CorazonHK/voice-recognition-project/F103-Version/Photos/完好的板子.jpg

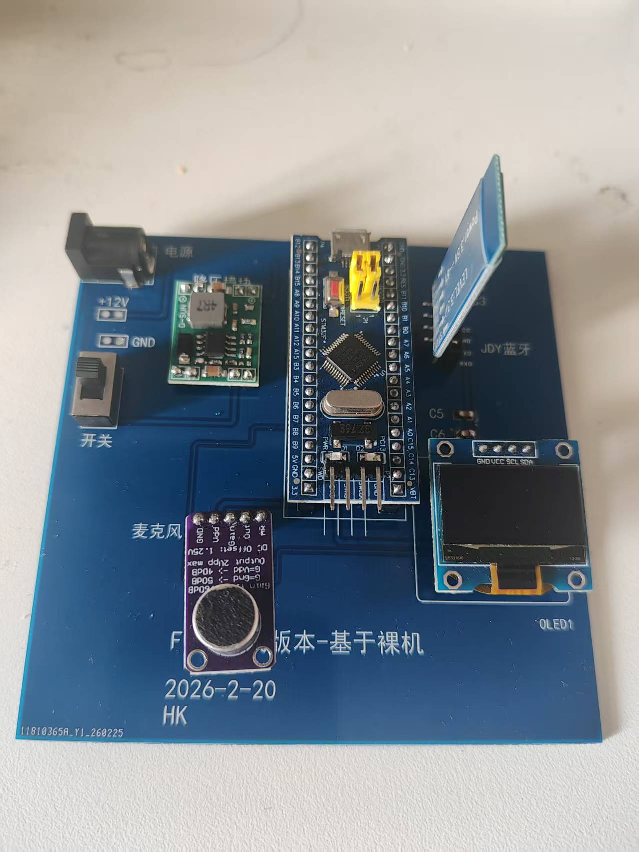
F103-Version/Photos/完好的板子.jpg
