CorazonHK/voice-recognition-project/F103-Version/Photos/烧坏的板子，短路过热.jpg

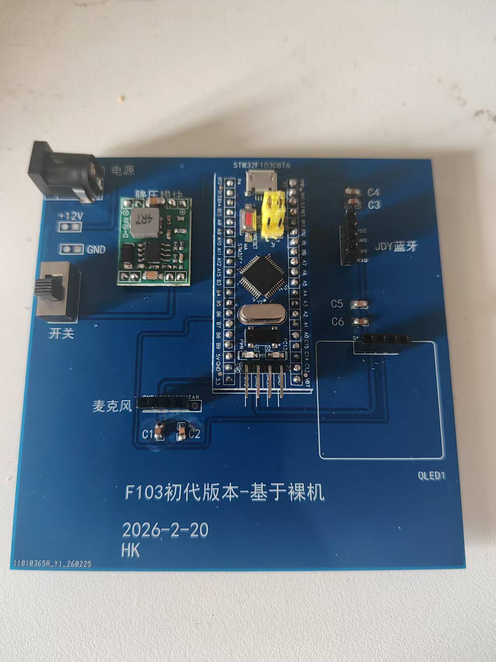
F103-Version/Photos/烧坏的板子，短路过热.jpg
