CorazonHK/voice-recognition-project/README.md

## STM32 语音控制系统

<div align="center">






**从 PCB 到 AI 的全栈语音识别项目 | 端侧采集 + PC 端识别**

[📚 文档](#-文档导航) | [🛠️ 硬件](#️-硬件设计) | [💻 固件](#-固件) | [🐍 Python](#-python-端) | [📊 成果](#-成果)

</div>

---

## 📌 项目简介

这是一个**从零开始**的语音控制系统，覆盖了：

- **硬件**：原理图设计、PCB  Layout、焊接调试
- **固件**：STM32 裸机开发、ADC+DMA 采集、串口通信
- **算法**：MFCC 特征提取、CNN 模型训练、实时推理
- **PC 端**：Python 服务器、数据采集、模型部署

**核心链路**：
```
声音 → MAX9814 麦克风 → STM32F103 采集 → HC-06 蓝牙 → PC 端 MFCC+CNN → 识别结果
```

---

## ✨ 功能特性

| 模块 | 功能 | 状态 |
| --- | --- | --- |
| 🎙️ 音频采集  | 8000Hz 采样，DMA 循环转运 | ✅ 完成 |
| 📡 蓝牙传输  | HC-06，9600bps，数据包协议 | ✅ 完成 |
| 🖥️ OLED 显示 | 实时显示识别结果、系统状态 | ✅ 完成 |
| 📝 数据采集  | PC 端脚本录制 文件 | ✅ 完成 |
| 🧠 模型训练  | MFCC + CNN，93% 准确率 | ✅ 完成 |
| ⚡ 实时识别  | Python 服务器实时推理 | ✅ 完成 |
| 🔋 电源系统  | 5V 输入，3.3V 稳压，去耦电容 | ✅ 完成 |
| 📦 版本迭代  | F103 原型 → F407 计划中 | 🚧 进行中 |

---

## 🛠️ 硬件设计

### 核心硬件

| 模块 | 型号 | 说明 |
| --- | --- | --- |
| 主控 | STM32F103C8T6 核心板 | 原型验证用 |
| 麦克风 | MAX9814 模块 | 自带 AGC，模拟输出  |
| 蓝牙 | HC-06 | 9600bps，最稳定 |
| 屏幕 | 0.96寸 OLED | I2C 接口，0x78 地址 |
| 电源 | 5V 降压模块 | 电池供电方案 |

### 引脚分配

| 模块 | 信号 | STM32 引脚 | 备注 |
| --- | ---- | --- | --- |
| 麦克风 | OUT  | PA0 | ADC 输入 |
| | VDD  | 3.3V | 加去耦电容 |
| | GND  | GND | 模拟地单独走 |
| 蓝牙 | TXD  | PB11 (USART3_RX) | 模块发送→STM32 接收 |
| | RXD  | PB10 (USART3_TX) | STM32 发送→模块接收 |
| | VCC  | 3.3V | 加去耦电容 |
| OLED | SCL  | PB6 | I2C 时钟 |
| | SDA  | PB7 | I2C 数据 |
| | VCC  | 3.3V | 加去耦电容 |

### PCB 设计要点

- **电源线加粗**：5V/3.3V 走 27mil
- **去耦电容**：每个模块 VCC 旁放 10μF+0.1μF，紧贴引脚
- **模拟地处理**：MAX9814 GND 单独走，单点接数字地

### 硬件版本迭代

| 版本 | 说明 | 状态 |
| ---- | --- | --- |
| v1.0 | 第一版 PCB（引脚排序错误） | ❌ 废板 |
| v1.1 | 修正 MAX9814 引脚排序 | ✅ 可用 |
| v1.2 | 优化去耦电容位置 | ✅ 稳定 |
| v2.0 | F407 版本（计划中） | 🚧 开发中 |

---

## 💻 固件

### 开发环境

- **IDE**：Keil MDK
- **库**：STM32 标准库
- **调试**：ST-Link

### 软件架构（裸机）

| 模块 | 实现 | 说明 |
| --- | --- | --- |
| ADC 采集  | DMA 循环模式，512 缓冲区 | 自动转运，不占 CPU |
| 蓝牙发送  | USART3，9600bps | 每 20ms 发一包 |
| OLED 显示 | I2C 驱动 | 实时显示状态 |
| 数据协议  | `AA 55` + 320 字节数据 + `0D 0A` | 帧头同步，防止粘包 |

## 🐍 Python 端

### 环境配置

| 组件 | 版本 | 说明 |
| --- | --- | --- |
| Python | 3.11 | TensorFlow 兼容版本 |
| TensorFlow | 2.15.0 | 训练和推理 |
| librosa | 0.10.1 | MFCC 特征提取 |
| pyserial | 最新 | 串口通信 |

```bash
# 创建虚拟环境
python -m venv .venv
.venv\Scripts\activate

# 安装依赖
pip install -r requirements.txt
```

### 脚本说明

| 脚本 | 功能 | 用法 |
| --- | --- | --- |
| `find_device.py` | 列出可用串口 | `python find_device.py` |
| `record_data_from_stm32.py` | 采集数据存 WAV | `python record_data_from_stm32.py` |
| `train_model.py` | 训练 CNN 模型  | `python train_model_from_stm32.py` |
| `getMFCC.py` | 实时识别 | `python getMFCC.py` |
| `test_env.py` | 验证环境 | `python test_env.py` |

### MFCC 特征提取

MFCC 是语音识别的黄金标准，主要优势：

- **模拟人耳**：梅尔刻度让机器“听得像人一样”
- **大幅降维**：16000 点 → 1300 维，压缩 12 倍
- **抗噪性强**：整个流程天然滤掉噪声

### 模型训练

- **模型**：3 层 Conv1D + 全连接
- **数据**：Google Speech Commands + 自采数据
- **准确率**：93%（测试集）
- **输出**：`speech_cnn.h5`

---

## 📊 成果

### 性能指标

| 指标 | 数值 |
| --- | --- |
| 采样率 | 8000Hz |
| 波特率 | 9600bps |
| 数据包 | 320 字节/包，20ms |
| 模型准确率 | 93% |
| 连续运行 | >24 小时 |
| 蓝牙距离 | >10 米 |

## 🚀 快速开始

### 硬件准备

1. 按 [引脚分配表] 连接模块
2. 接入 5V 电源
3. 用 ST-Link 下载固件

### 固件烧录

```bash
# 打开 Keil 工程
Firmware/F103/MDK-ARM/Project.uvprojx

# 编译下载
```

### Python 环境

```bash
# 创建虚拟环境
python -m venv .venv
.venv\Scripts\activate

# 安装依赖
pip install -r Python/requirements.txt

# 运行实时识别
python Python getMFCC.py
```

---

## 🧠 经验总结

### 硬件

1. **以实物为准**：MAX9814 引脚排序
2. **电源线要粗**：20-30mil 起步
3. **电容要贴芯片放**：0.1μF 必须紧贴引脚

### 软件

1. **裸机够用就别急着上系统**
2. **帧头同步很重要**：`AA 55` 解决粘包问题
3. **数据分包比降低速率更有效**

### 算法

1. **MFCC 参数不能错**：训练和推理必须一致
2. **CMSIS-DSP 有坑**：arm_bitreversal 自己手写 fix
3. **数据增强有用**：加了噪声后识别率提升明显

---

## 📄 许可证

MIT License

---

## 🙏 致谢

- 江协科技 - 标准库教程
- 正点原子 - FreeRTOS 教程
- Google - Speech Commands 数据集
- librosa 团队 - 优秀的音频处理库

---

<div align="center">

**如果这个项目对你有帮助，欢迎 Star ⭐**

</div>
