CorazonHK/voice-recognition-project/F103-Version/Docs/F103版本说明.md

## F103 版本说明

> 📅 **版本**：v1.0  
> 🔧 **主控**：STM32F103C8T6  
> 📌 **状态**：✅ 已完成（原型验证）  
> 🎯 **用途**：快速验证硬件方案 + 算法可行性

---

### 🎯 这个版本的目标

F103 版本从一开始就不是“最终产品”，它的定位很明确：

| 目标 | 说明 |
| --- | --- |
| ✅ 快速验证硬件 | MAX9814、HC-06、OLED 能不能正常工作 |
| ✅ 打通通信链路 | 音频数据能不能从 STM32 传到 PC |
| ✅ 验证算法 | MFCC + CNN 在 PC 端能不能跑通 |
| ✅ 采集真实数据 | 用这套硬件录一批自己的语音 |
| ❌ 不是最终架构 | 不上 FreeRTOS，不用复杂架构 |

**一句话**：先让东西跑起来，再考虑怎么跑得好。

---

### 📦 这个版本做了什么

#### 硬件方面

| 模块 | 型号 | 状态 |
| --- | --- | --- |
| 主控 | STM32F103C8T6 核心板  | ✅ 稳定 |
| 麦克风 | MAX9814 模块 | ✅ 稳定（引脚排序已核对） |
| 蓝牙 | HC-06 | ✅ 稳定（9600bps） |
| 屏幕 | 0.96寸 OLED | ✅ 稳定（I2C 0x78） |
| 电源 | 5V 降压模块 + AMS1117 | ✅ 稳定 |

**硬件迭代记录**：
- 第一版 PCB：发现 MAX9814 引脚排序和网上资料不一样 → 第二版修正
- 第二版 PCB：蓝牙从 JDY-31 换成 HC-06 → 稳定性大幅提升
- 第三版 PCB：去耦电容位置优化 → ADC 数据跳动从 ±20 降到 ±2

#### 软件方面（裸机）

| 模块 | 实现方式 | 状态 |
| --- | --- | --- |
| ADC 采集 | DMA 循环模式，512 缓冲区 | ✅ 稳定 |
| 蓝牙发送 | USART3，9600bps，帧头 `AA 55` + 数据 + `0D 0A` | ✅ 稳定 |
| OLED 显示  | I2C 驱动，显示实时状态 | ✅ 稳定 |
| 数据包协议 | 每包 320 字节（160 个采样点） | ✅ 稳定 |

#### PC 端

| 脚本 | 功能 | 状态 |
| --- | --- | --- |
| `record_word_from_stm32.py` | 采集数据，存 WAV | ✅ 可用 |
| `train_model_from_stm32.py` | 训练 CNN 模型 | ✅ 可用（93% 准确率） |
| `getMFCC.py` | 实时识别 | ✅ 可用 |
| `find_device.py` | 列出可用串口 | ✅ 可用 |
| `test_env.py` | 验证 Python 环境 | ✅ 可用 |

---

### 📊 这个版本的成果

| 指标 | 数值 | 说明 |
| --- | --- | --- |
| 采样率 | 8000Hz | 语音识别够用 |
| 波特率 | 9600bps | HC-06 最稳定 |
| 数据包大小 | 320 字节/包 | 160 个采样点 |
| 发送间隔 | 20ms | 和帧率匹配 |
| 模型准确率 | 93% | 在自己录的数据集上 |
| 连续运行时间 | >24 小时 | 不卡死、不掉线 |
| 蓝牙有效距离 | >10 米 | 室内够用 |

---

### 🧠 学到了什么

#### 硬件方面的经验

1. **以实物为准**  
   MAX9814 的引脚排序让我长记性了：永远不要相信网上的引脚图，拿到模块先拿万用表打一遍。

2. **电源线要粗**  
   第一版板子电源线太细，蓝牙一发射电压就掉。后来加粗到 27mil，问题解决。

3. **电容要贴芯片放**  
   去耦电容放远了等于白放。0.1μF 必须紧贴芯片引脚，这个坑我踩过。

#### 软件方面的经验

1. **裸机够用就别急着上系统**  
   F103 版本没用 FreeRTOS，少了很多调试的麻烦。先把功能跑通，上系统的事留给 F407。

2. **帧头同步很重要**  
   一开始没加帧头，PC 端经常收错数据。加上 `AA 55` 之后，再也没出过问题。

3. **数据分包比降低速率更有效**  
   从一次发 1024 字节改成每 20ms 发 320 字节，传输稳定性大幅提升。

#### 算法方面的经验

1. **MFCC 的参数不能错**  
   hop_length、n_mfcc、n_fft 这些参数，训练和推理必须完全一致，否则识别率直接归零。

2. **CMSIS-DSP 有坑**  
   arm_bitreversal_32 链接不上的问题，最后自己手写 fix 才解决。官方库不一定靠谱。

---

### ⚠️ 这个版本的局限

1. **裸机架构，代码耦合度高**  
   所有功能都挤在 main 循环里，加新功能越来越难。

2. **没有用 FreeRTOS**  
   任务管理靠轮询，实时性一般，CPU 利用率不高。

3. **F103 的 RAM 太小**  
   20KB 要放 ADC 缓冲区、全局变量、栈，有点捉襟见肘。

4. **采样率只有 8000Hz**  
   够用，但想提高识别率的话，还是 16000Hz 更好。

5. **蓝牙还是 9600bps**  
   稳是稳，但想传更高质量的数据，带宽不够。

---

### 🚀 F407 版本计划怎么改进

| 改进点 | F103 版本 | F407 版本计划 |
| --- | --- | --- |
| 操作系统 | 裸机 | **FreeRTOS**  |
| 任务数 | 1个 main 循环 | 4个独立任务 |
| 数据传递 | 全局变量 | **队列** |
| 采样率 | 8000Hz | **16000Hz** |
| 缓冲区 | 512 点 | **1024 点** |
| RAM | 20KB | 192KB（够用） |
| 代码可维护性 | 一般 | **好** |

---

### 📝 总结

F103 版本的任务完成了：
- ✅ 硬件方案验证通过
- ✅ 通信链路打通
- ✅ 算法跑通，准确率 93%
- ✅ 数据采集搞定

它的价值不是“能跑多快”，而是**让 F407 版本可以站在它的肩膀上**。

没有 F103 版本踩的那些坑，F407 版本不可能一次成功。

---
