CorazonHK/voice-recognition-project/F103-Version/Docs/硬件引脚分配表.md

## 硬件引脚分配表（STM32F103C8T6）

> 📅 **版本**：F103原型验证版  
> 🔧 **主控**：STM32F103C8T6核心板   
> ⚠️ **注意**：蓝牙用的是 **USART3**，且 **TXD/RXD 是交叉连接**

---

### 📍 引脚分配总表

| 模块 | 引脚 | STM32引脚 | 功能 | 备注 |
| --- | --- | --- | --- | --- |
| **电源** | 5V_IN | 核心板5V脚 | 系统总电源 | 从5V降压模块来 |
| | 3.3V | 核心板3.3V脚 | 给外设供电 | 核心板输出 |
| | GND | 核心板GND | 公共地 | 所有GND最后铺铜连接 |
| **麦克风** | OUT | **PA0** | 音频模拟输入 | ADC1_CH0 |
| (MAX9814) | VDD | 3.3V | 模块供电 | 加10μF+0.1μF去耦 |
| | GND | GND | 电源地 | 模拟地单独走线 |
| | GAIN | 悬空 | 增益选择 | 悬空=60dB |
| | AR | 悬空 | 攻击/释放比 | 悬空=1:4000 |
| **蓝牙** | **TXD** | **PB11 (USART3_RX)** | 模块发送→STM32接收 | ⭐ 注意：PB11 是 RX  |
| (HC-06) | **RXD** | **PB10 (USART3_TX)** | STM32发送→模块接收 | ⭐ 注意：PB10 是 TX  |
| | VCC | 3.3V | 模块供电 | 加10μF+0.1μF去耦 |
| | GND | GND | 电源地 | |
| **OLED** | SCL | **PB6** (I2C1_SCL) | I2C时钟线 | 模块自带4.7k上拉 |
| (0.96寸) | SDA | **PB7** (I2C1_SDA) | I2C数据线 | 模块自带4.7k上拉 |
| | VCC | 3.3V | 模块供电 | 加10μF+0.1μF去耦 |
| | GND | GND | 电源地 | |
| **调试接口** | SWDIO | **PA13** | 调试数据线 | 核心板引出 |
| | SWCLK | **PA14** | 调试时钟线 | 核心板引出 |
| | NRST | NRST | 复位 | 可选，接调试器 |

---

### 🔌 蓝牙接线特别说明

**这是最容易接错的地方，一定要看仔细：**

| HC-06 引脚 | 接 STM32 引脚 | 说明 |
| --- | --- | --- |
| TXD（模块发送） | **PB11 (USART3_RX)** | 模块发送 → STM32 接收 |
| RXD（模块接收） | **PB10 (USART3_TX)** | STM32 发送 → 模块接收 |

**口诀**：**TXD 接 RX，RXD 接 TX**（交叉连接）

---

### 📊 按外设分组

#### 电源网络
| 网络名 | 来源 | 去向 | 线宽建议 |
| --- | --- | --- | --- |
| 5V_IN  | 电源接口 | 核心板5V脚  | 20-30mil |
| 3.3V | 核心板3.3V脚 | 所有外设VCC | 20mil |
| GND | 电源接口 | 所有外设GND | 铺铜 |

#### 模拟信号（要特别小心）
| 信号 | 引脚 | 注意事项 |
| --- | ---- | --- |
| 麦克风输入 | PA0  | 走线尽量短，远离数字信号 |

#### 数字通信
| 接口 | 引脚 | 功能 | 速率 |
| --- | ---- | --- | --- |
| USART3_TX | PB10 | 蓝牙发送（STM32→模块） | 9600bps |
| USART3_RX | PB11 | 蓝牙接收（模块→STM32） | 9600bps |
| I2C1_SCL  | PB6  | OLED时钟 | 100kHz  |
| I2C1_SDA  | PB7  | OLED数据 | 100kHz  |

---

### 🎯 选型理由

#### PB10/PB11 做蓝牙
- 用 USART3 避开 USART1（PA9/PA10 留着备用）
- 核心板引出这些脚，不用飞线
- HC-06 默认 9600bps，正好匹配

#### 为什么 TXD 接 PB11？
- HC-06 的 TXD 是**发送**数据
- STM32 的 PB11 是 USART3 的 **RX（接收）**
- 一个发一个收，正好对上

---

### 📐 PCB 布局建议

1. **PA0 麦克风输入**
   - 尽量靠近麦克风模块
   - 周围不要走数字信号线
   - 最好用地线包起来

2. **PB10/PB11 蓝牙**
   - 放在板子边缘（天线朝外）
   - 天线下方不要铺铜、不要走线
   - 远离电机、电源等干扰源

3. **PB6/PB7 OLED**
   - 放在方便插屏幕的位置
   - I2C 走线可以长一点，没问题

4. **电源线**
   - 5V_IN 和 3.3V 走 20-30mil
   - 每个模块旁边放 10μF+0.1μF 去耦电容

---

### ⚠️ 实测确认过的事

| 项目 | 状态 | 说明 |
| --- | --- | --- |
| MAX9814 引脚排序 | ✅ 已核对 | 实物是 1-GND, 2-VDD, 3-GAIN, 4-OUT, 5-AR |
| HC-06 波特率 | ✅ 已确认 | 默认 9600，代码里也设 9600 |
| **HC-06 接线** | ✅ **已确认** | **PB10(TX) → HC-06 RXD，PB11(RX) → HC-06 TXD** |
| OLED I2C 地址 | ✅ 已确认 | 模块背面 R1/R8 配置，当前是 0x78 |
| 上拉电阻 | ✅ 已确认 | OLED 模块自带，PCB 不加 |

---

### 📝 代码里对应的配置

```c
// ADC 初始化（PA0）
ADC_ChannelConf.Channel = ADC_CHANNEL_0;

// USART3 初始化（PB10 TX, PB11 RX）
USART3_BaudRate = 9600;  // 和 HC-06 匹配
GPIO_Pin_10 = PB10;      // TX（STM32发送）
GPIO_Pin_11 = PB11;      // RX（STM32接收）

// 发送一个字节
void HC06_SendByte(uint8_t data)
{
    USART_SendData(USART3, data);
    while(USART_GetFlagStatus(USART3, USART_FLAG_TXE) == RESET);
}

// 接收一个字节
uint8_t HC06_ReceiveByte(void)
{
    while(USART_GetFlagStatus(USART3, USART_FLAG_RXNE) == RESET);
    return USART_ReceiveData(USART3);
}
```

---

### 🔄 如果要改到 F407

| 功能 | F103 引脚 | F407 引脚 | 备注 |
| --- | --- | --- | --- |
| 麦克风 | PA0 | PA0 | 可以不改 |
| 蓝牙 TX  | PB10 | PB10 | 可以不改 |
| 蓝牙 RX  | PB11 | PB11 | 可以不改 |
| OLED SCL | PB6 | PB6 | 可以不改 |
| OLED SDA | PB7 | PB7 | 可以不改 |

F407 版本可以直接复用这套引脚分配，不用重新设计。
