CorazonHK/voice-recognition-project/F103-Version/Photos/空板.jpg

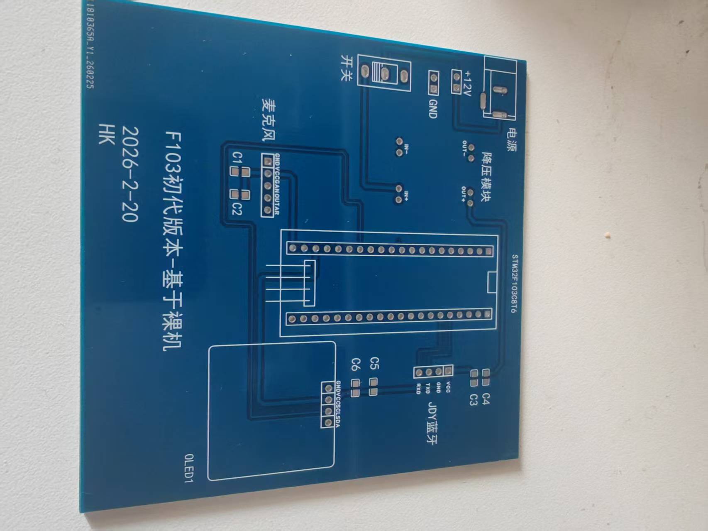
F103-Version/Photos/空板.jpg
