CorazonHK/voice-recognition-project/F103-Version/Hardware/BOM_Board2_1_Schematic2_1_2026-03-07.xlsx

No. | Quantity | Comment | Designator | describe
1 | 3 | 100nF | C1,C3,C6 | C0805贴片
2 | 3 | 10UF | C2,C4,C5 | C0805贴片
3 | 1 | KH-DC-005-2.5 | DC2 | DC-005 5.5-2.1 耐高温
4 | 1 | 2.54-1*5P母 | H4 | 麦克风用的排座
5 | 1 | 0.96OLED_4P_MODULE_JX | OLED1 | 0.96寸 IIC协议OLED 4引脚
6 | 1 | stm32f103c8t6最小系统板 | U3 | STM32F103C8T6核心板
7 | 1 | 蓝牙模块HC-06 | U6 | DIP-1X4P2.54（HC-06蓝牙模块）
8 | 1 | SS-12D10-G5 | U12 | SS12D06 SS12D10 5MM柄高 2档3脚 大电流拨动开关
9 | 1 | MP1584模块 | U13 | MP1584模块，买固定5V输出
10 | 2 | PM254-1-02-Z-8.5 | U14,U15 | HDR-TH_2P-P2.54-V-F
11 | 1 | MAX9814麦克风 |  | 淘宝买现成模块
12 | 2 | 2.54-1*4P母 |  | 蓝牙 OLED用的排母
13 | 4 | 单排直针2.54 1*2铁 |  | 降压模块用的1*2排针，需要4个
14 | 2 | 单排直针2.54 1*20铁 |  | 最小系统板用的1*20排针，需要2个
15 | 1 | 电池及充电器 |  | 德力普12v锂电电池组 大容量
