CorazonHK/voice-recognition-project/F103-Version/Hardware/PCB_标准版_2026-03-07.pdf

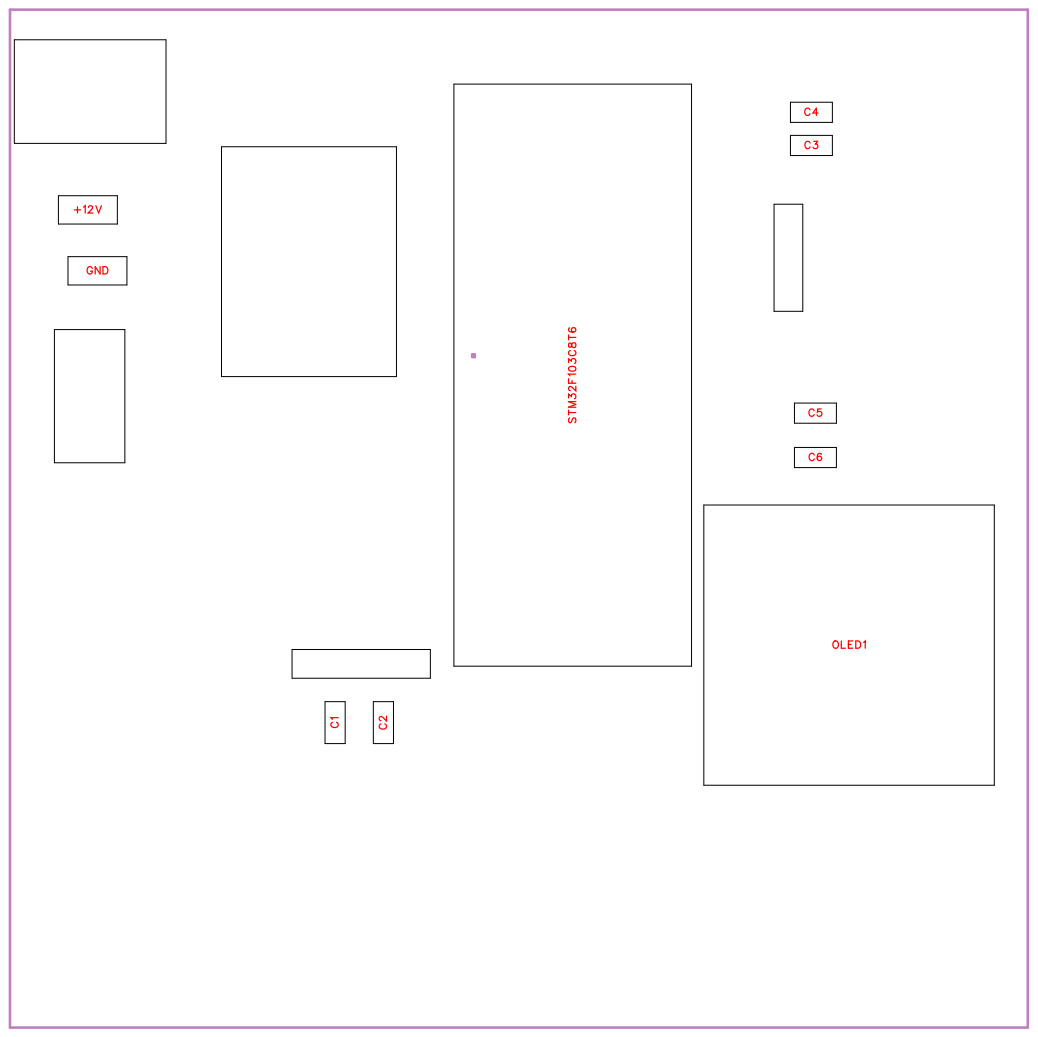
[picture p4: page 1]

No. | Quantity | Comment | Designator | Footprint | Value | Manufacturer Part | Manufacturer | Supplier Part | Supplier
1 | | 蓝牙模块HC-06 | | DIP-1X4P2.5 4（HC-06蓝 牙模块）
2 | | 2.54-1*5P 母 | | HDR-TH_5P-P2.54-V-F | | 2.54-1*5P 母 | BOOMELE( ) 博穆精密 | C50950 | LCSC
3 | 2 | PM254-1-02-Z-8.5 | +12V,GND | HDR-TH_2P-P2.54-V-F | | PM254-1-02-Z-8.5 | HCTL(华灿天 禄) | C2897365 | LCSC
4 | 2 | 100nF | C1,C3 | C0805 | 100nF
5 | 3 | 10UF | C2,C4,C5 | C0805 | 10UF
6 | 1 | 0.1UF | C6 | C0805 | 0.1UF
7 | 1 | 0.96OLED_4 P_MODULE_ JX | OLED1 | 0.96OLED_4 P | | 0.96OLED_4 P_MODULE_ JX | | C990000456 6 | LCSC
8 | 1 | stm32f103c8t 6最小系统板 | STM32F103C8T6 | STM32F103 C8T6核心板
9 | 1 | SS-12D10-G 5 | 开关 | SW-TH_SS-1 2D10-G050 | | SS-12D10-G 5 | DEALON( 德 艺隆 ) | C2998777 | LCSC
10 | 1 | KH-DC-005-2 .5 | 电源 | DC-IN-TH_K H-DC-005-2. 5 | | KH-DC-005-2 .5 | kinghelm( 金 航标 ) | C2847170 | LCSC
11 | 1 | MP1584模块 | 降压模块 | MP1584模块

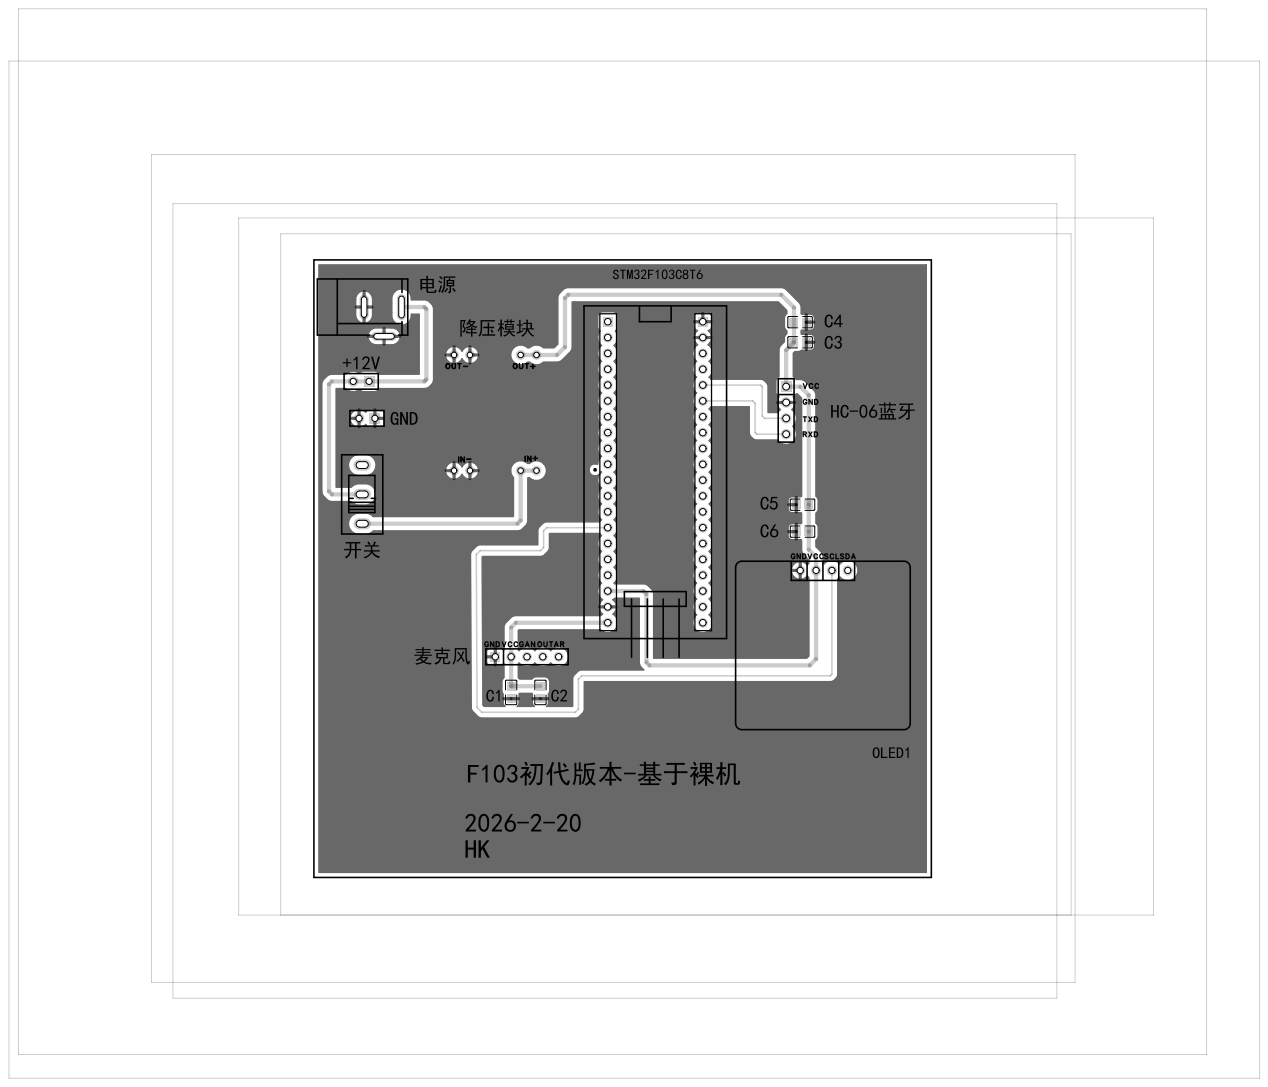
[picture p5: page 4]

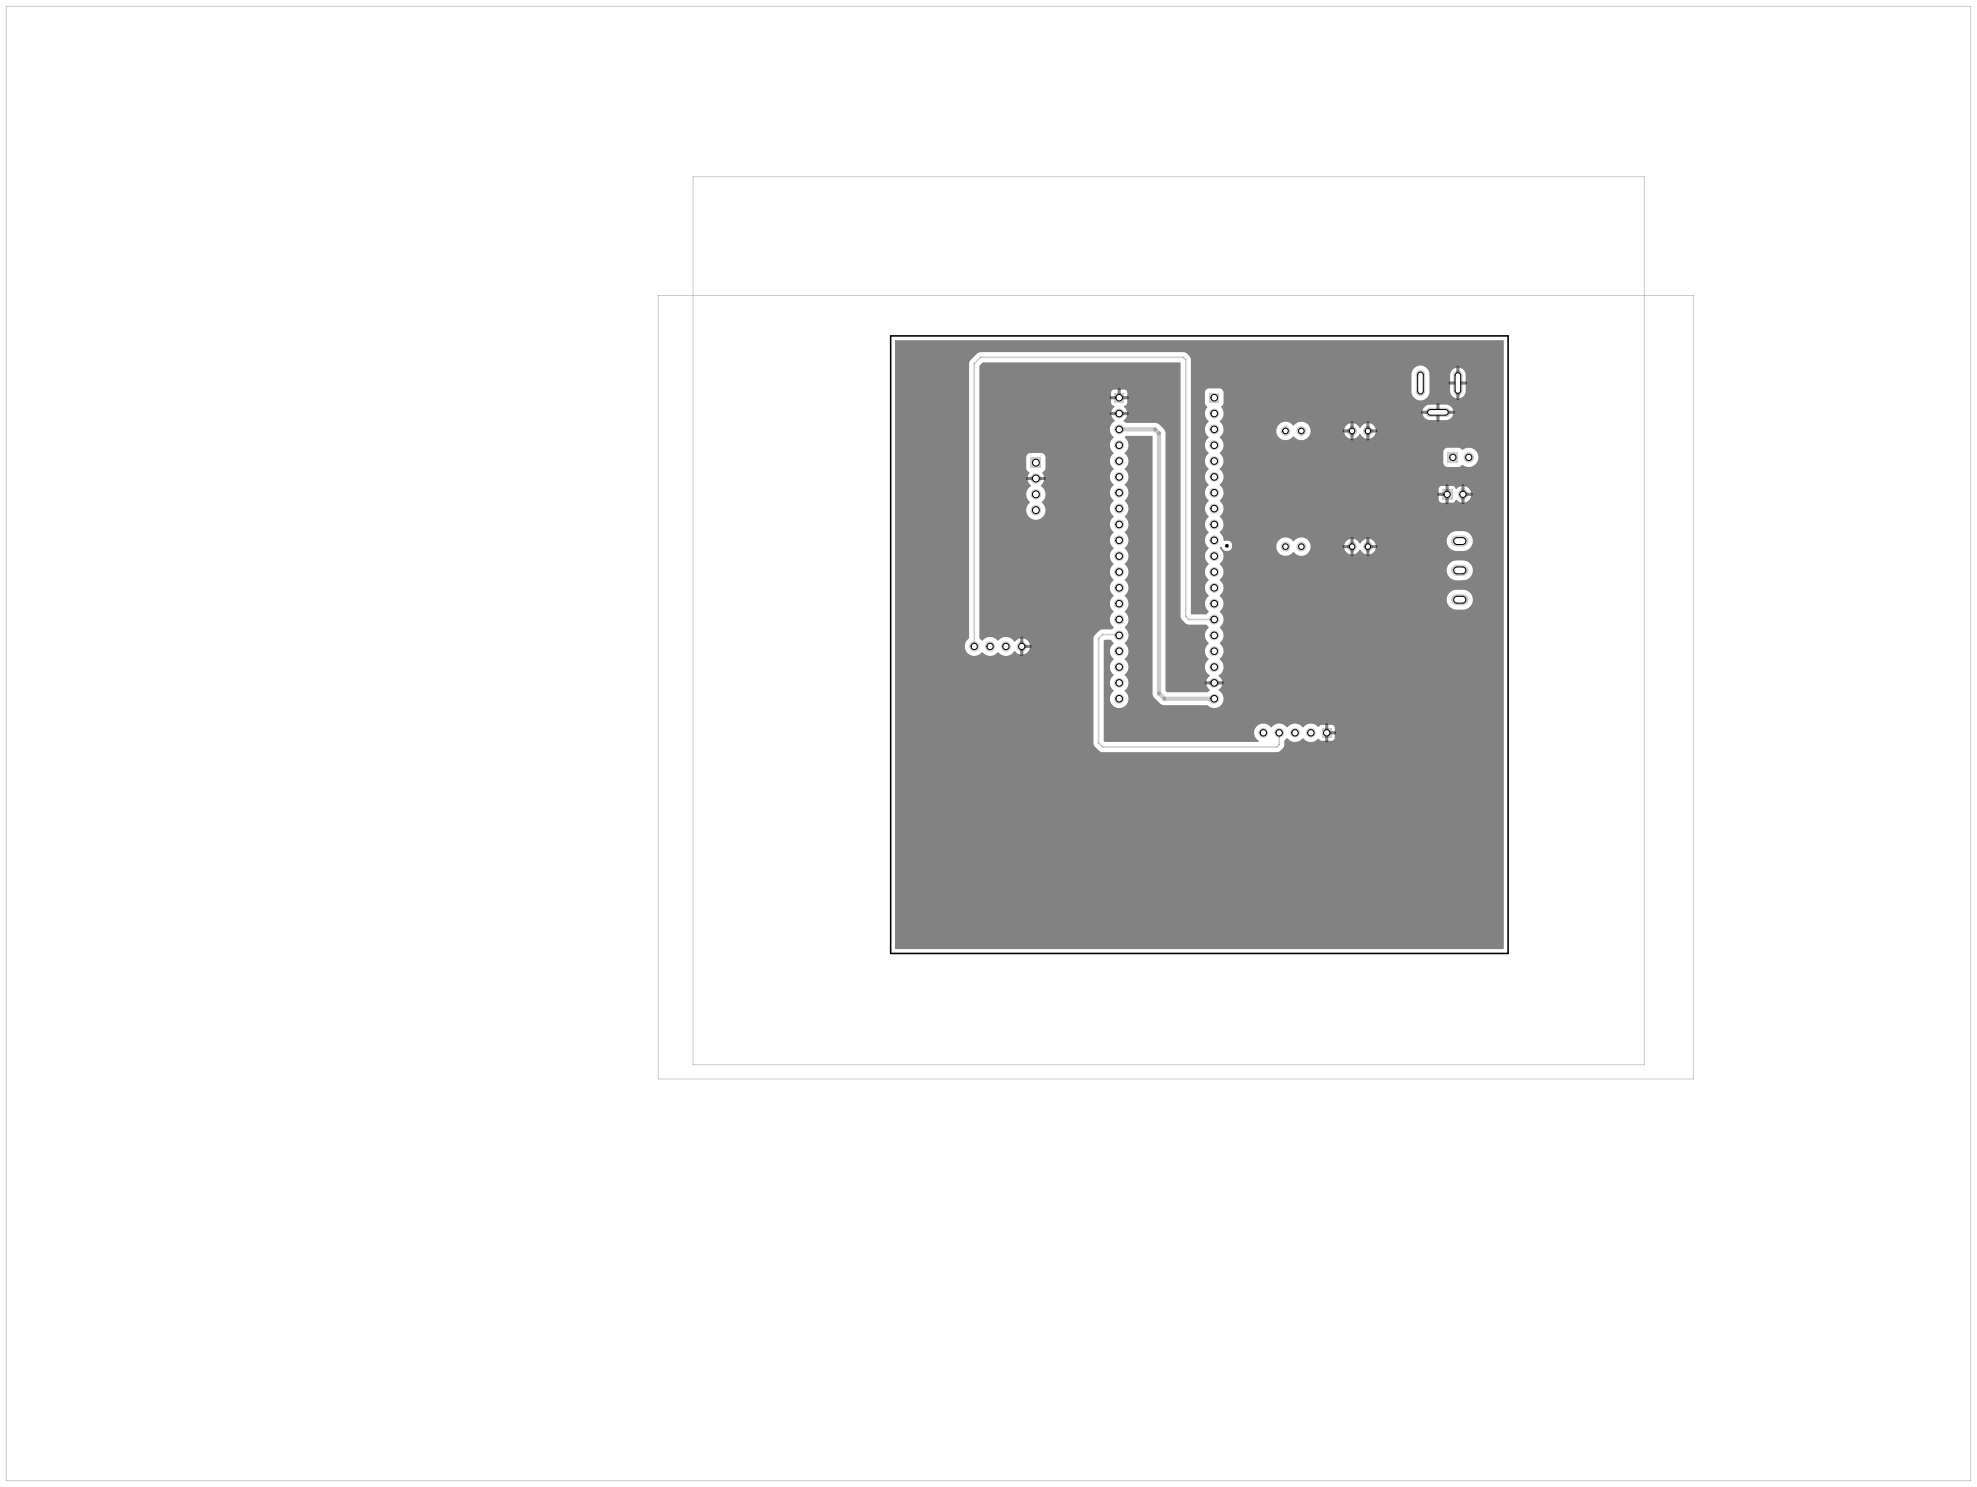
[picture p6: page 5]

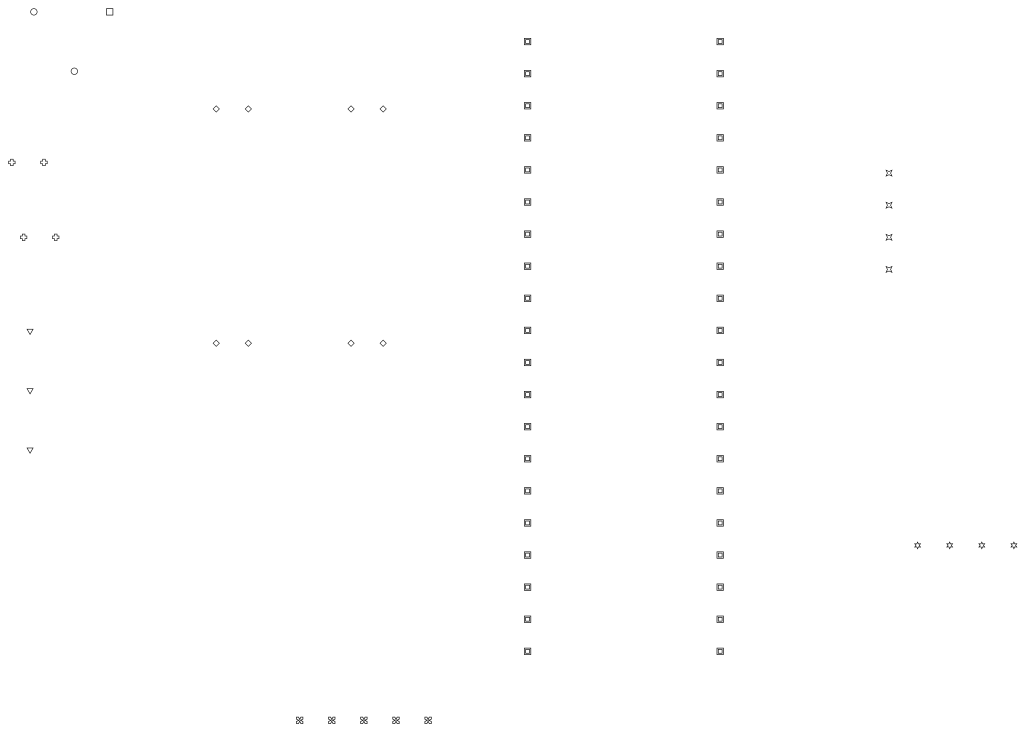
[picture p7: page 6]
