CorazonHK/voice-recognition-project/F103-Version/Hardware/SCH_Schematic2_1_2026-03-07.pdf

+12V

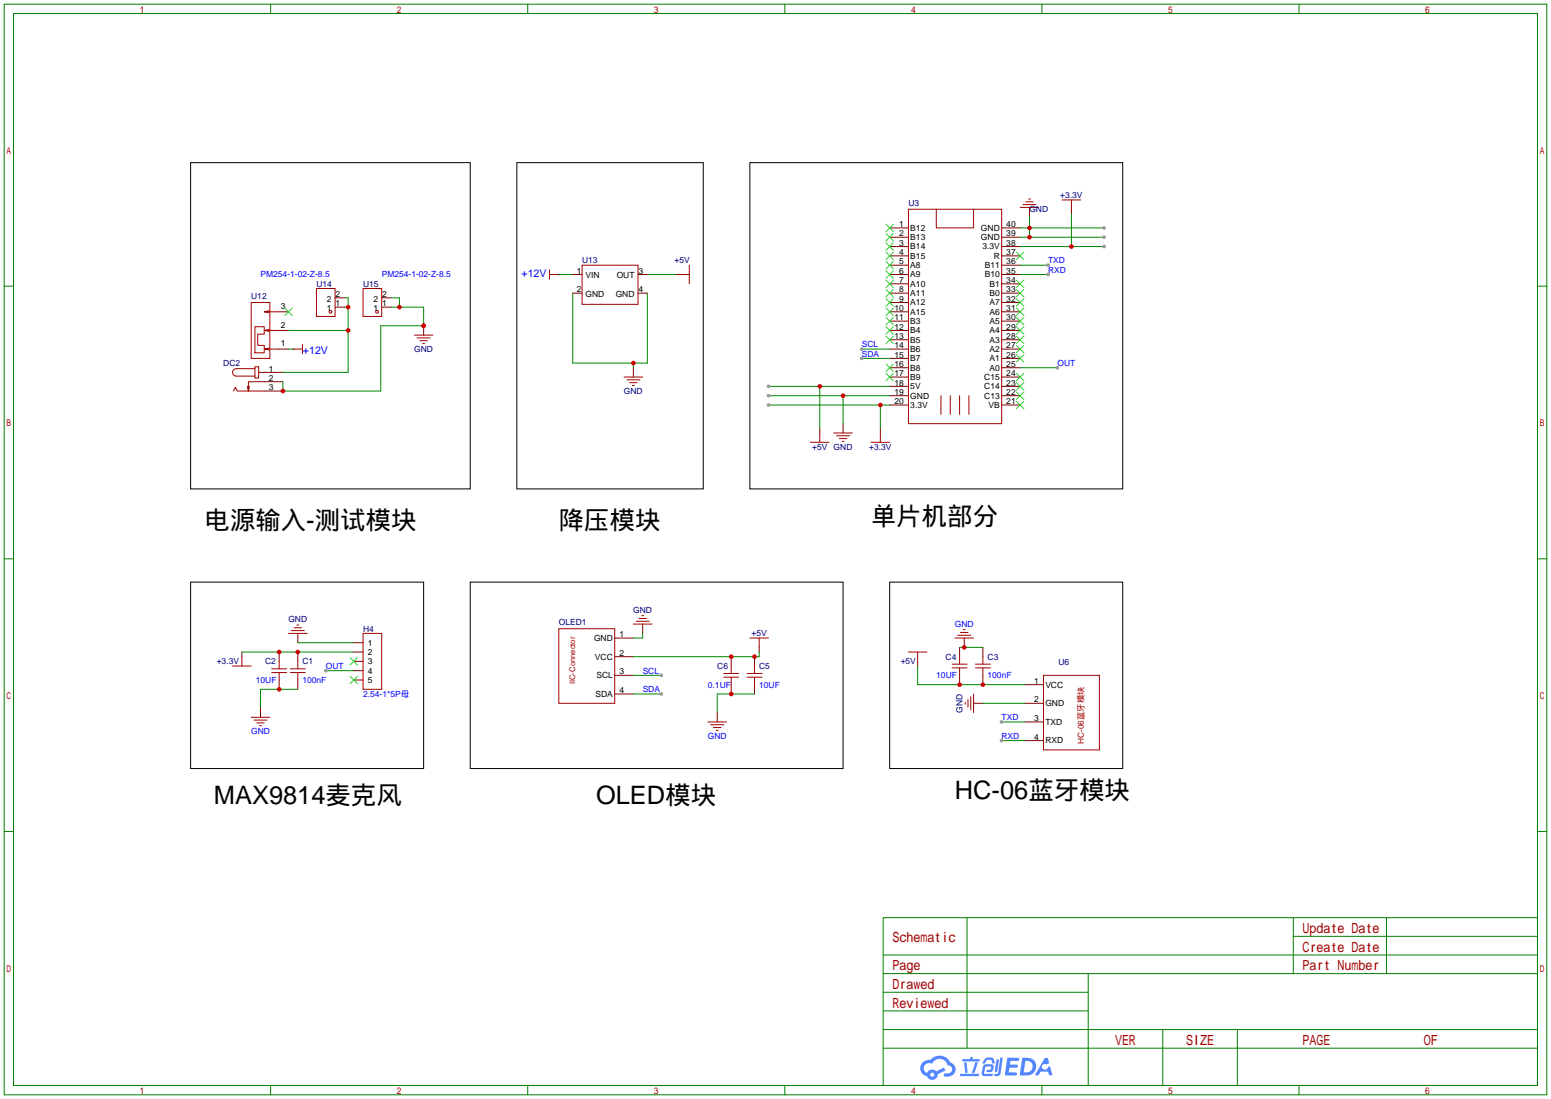
[picture p8: page 1]
