CorazonHK/voice-recognition-project/F103-Version/Stm32 Codes/Hardware/AD.c

#include "stm32f10x.h"                  // Device header

/**
  * 语音AD值存放数组
  * 大小：512个半字（16位）
  * 说明：每通道1个，用于存放ADC转换结果
  *       512个点 × 16位 = 1KB 缓冲区
  */
uint16_t AD_Value[512];					// 定义用于存放语音AD转换结果的全局数组

/**
  * 函    数：AD初始化（单通道，连续转换）
  * 参    数：无
  * 返 回 值：无
  */
void AD_Init(void)
{
	/*开启时钟*/
	RCC_APB2PeriphClockCmd(RCC_APB2Periph_ADC1, ENABLE);	//开启ADC1的时钟
	RCC_APB2PeriphClockCmd(RCC_APB2Periph_GPIOA, ENABLE);	//开启GPIOA的时钟
	
	/*设置ADC时钟*/
	RCC_ADCCLKConfig(RCC_PCLK2_Div6);						//选择时钟6分频，ADCCLK = 72MHz / 6 = 12MHz
	
	/*GPIO初始化——只保留PA0（麦克风输入）*/
	GPIO_InitTypeDef GPIO_InitStructure;
	GPIO_InitStructure.GPIO_Mode = GPIO_Mode_AIN;
	GPIO_InitStructure.GPIO_Pin = GPIO_Pin_0;				// 只保留PA0
	GPIO_InitStructure.GPIO_Speed = GPIO_Speed_50MHz;
	GPIO_Init(GPIOA, &GPIO_InitStructure);					//将PA0引脚初始化为模拟输入
	
	/*规则组通道配置——只保留通道0（PA0）*/
	ADC_RegularChannelConfig(ADC1, ADC_Channel_0, 1, ADC_SampleTime_55Cycles5);	//规则组序列1的位置，配置为通道0
	
	/*ADC初始化*/
	ADC_InitTypeDef ADC_InitStructure;											//定义结构体变量
	ADC_InitStructure.ADC_Mode = ADC_Mode_Independent;							//模式，选择独立模式，即单独使用ADC1
	ADC_InitStructure.ADC_DataAlign = ADC_DataAlign_Right;						//数据对齐，选择右对齐
	ADC_InitStructure.ADC_ExternalTrigConv = ADC_ExternalTrigConv_None;			//外部触发，使用软件触发，不需要外部触发
	ADC_InitStructure.ADC_ContinuousConvMode = ENABLE;							//连续转换，使能，每转换一次后立刻开始下一次转换
	ADC_InitStructure.ADC_ScanConvMode = DISABLE;								//扫描模式，失能，单通道不需要扫描
	ADC_InitStructure.ADC_NbrOfChannel = 1;										//通道数，为1
	ADC_Init(ADC1, &ADC_InitStructure);											//将结构体变量交给ADC_Init，配置ADC1
	
	/*ADC使能*/
	ADC_Cmd(ADC1, ENABLE);									//ADC1使能
	ADC_DMACmd(ADC1, ENABLE);
	
	/*ADC校准*/
	ADC_ResetCalibration(ADC1);								//固定流程，内部有电路会自动执行校准
	while (ADC_GetResetCalibrationStatus(ADC1) == SET);
	ADC_StartCalibration(ADC1);
	while (ADC_GetCalibrationStatus(ADC1) == SET);
	
	/*ADC触发——启动连续转换*/
	ADC_SoftwareStartConvCmd(ADC1, ENABLE);	//软件触发ADC开始工作，由于ADC处于连续转换模式，故触发一次后ADC就可以一直连续不断地工作
}
