CorazonHK/voice-recognition-project/(commit log)

2026-03-02 Add schematic for F103 hardware
2026-03-02 add schematic.pdf,Gerber files
2026-03-02 add bom list
    [BOM_Board2_1_标准版_2026-03-02.xlsx]
2026-03-07 提交硬件相关文件
    [BOM_Board2_1_Schematic2_1_2026-03-07.xlsx]
2026-03-07 add gerber file
2026-03-07 add pdf of pcb
