CorazonHK/voice-recognition-project/(notices)

Notices in the files:
README.md:
License: MIT
